manadream/triple-bypass-Version-2/bom/3bpv2-m bom alternate.xlsx

ID | Designator | Footprint | Quantity | Value | Manufacturer Part | Manufacturer | Description
1 | C1, C2, C20, C3, C4, C5, C6 | 0603' | 7 | 0.1uF/50V | 06035C104M4T2A | AVX
2 | C10, C11, C12, C13, C14, C15 | 0603' | 6 | 1uF/16V | C0603C105K4PACTU | KEMET
3 | C16, C9 | 0805’ | 2 | 10uF/16V | EMK212BJ106KG-T | Taiyo Yuden
4 | C17 | 1206’ | 1 | 10uF/25V | TMK316AB7106KLHT | Taiyo Yuden
5 | C18, C19 | 0603' | 2 | 150pF/50V | 0603N151J500CT | Walsin
6 | C21, C22, C23 | CP_EIA-3528-15_AVX-H | 3 | 47uF/10V | TAJB476M010TNJ | AVX
7 | C7 | 1206’ | 1 | 22uF/25V | CL31A226KAHNNNE | Samsung
8 | C8 | CP_EIA-3528-15_AVX-H | 1 | 220uF/6.3V | T55B227M6R3C0025 | Vishay
9 | R1, R15 | 0603' | 2 | 2.20k | CRCW06032K20FKEB | Vishay
10 | R10, R43 | 0603' | 2 | 4.7k | RK73H1JTTD4701F | KOA Speer
11 | R11, R14, R17 | 0603' | 3 | 75 | RK73H1JTTDD75R0F | KOA Speer
12 | R16 | 0603' | 1 | 750 | CR0603-FX-7500ELF | Bourns
13 | R2, R3, R4, R5 | 0603' | 4 | 5.62k | AC0603FR-075K62L | YAGEO
14 | R20, R21, R22, R23, R24, R25 | 0603' | 6 | 210k | AC0603FR-07210KL | YAGEO
15 | R26, R27, R30, R33, R41, R42 | 0603' | 6 | 10k | RK73H1JTTD1002F | KOA Speer
16 | R28, R31 | 0603' | 2 | 130k | CR0603-FX-1303ELF | Bourns
17 | R29, R32 | 0603' | 2 | 100k | RK73H1JTTD1003F | KOA Speer
18 | R34, R35 | 0603' | 2 | 300k | RK73H1JTTD3003F | KOA Speer
19 | R36, R37, R44 | 0603' | 3 | 330 | RK73H1JTTD3300F | KOA Speer
20 | R38, R39, R40 | 0603' | 3 | 511 | RK73H1JTTD5110F | KOA Speer
21 | R6, R7, R8, R9 | 0603' | 4 | 1k | RK73H1JTTD1001F | KOA Speer
22 | U1 | SOIC-14 | 1 | TL974IDR | TL974IDR | Texas Instruments
23 | U2 | TSSOP-14 | 1 | THS7374IPWR | THS7374IPWR | Texas Instruments
