manadream/triple-bypass-Version-2/bom/3bpv2-m bom pcb power.xlsx

ID | Designator | Footprint | Quantity | Value | Manufacturer Part | Manufacturer | Description
1 | C1, C2, C20, C3, C4, C5, C6 | 0603' | 7 | 0.1uF/50V | C0603C104M5RACTU | KEMET
2 | C10, C11, C12, C13, C14, C15 | 0603' | 6 | 1uF/16V | C0603C105K4PACTU | KEMET
3 | C16, C9 | 0805’ | 2 | 10uF/16V | EMK212BJ106KG-T | Taiyo Yuden
4 | C17 | 1206’ | 1 | 10uF/25V | CL31B106KAHNNNE | Samsung
5 | C18, C19 | 0603' | 2 | 150pF/25V | CC0603KRX7R8BB151 | YAGEO
6 | C21, C22, C23 | CP_EIA-3528-15_AVX-H | 3 | 47uF/10V | TAJB476M010TNJ | AVX
7 | C7 | 1206’ | 1 | 22uF/25V | CL31A226KAHNNNE | Samsung
8 | C8 | CP_EIA-3528-15_AVX-H | 1 | 220uF/6.3V | F930J227MBA | AVX
9 | R1, R15 | 0603' | 2 | 2.20k | GPR06032K2 | PCB Power
10 | R10, R43 | 0603' | 2 | 4.7k | GPR06034K7 | PCB Power
11 | R11, R14, R17 | 0603' | 3 | 75 | ERJ-3GEYJ750V | Panasonic
12 | R16 | 0603' | 1 | 750 | CR0603-FX-7500ELF | Bourns
13 | R2, R3, R4, R5 | 0603' | 4 | 5.62k | RK73H1JTTD5621F | KOA Speer
14 | R20, R21, R22, R23, R24, R25 | 0603' | 6 | 210k | CRCW0603210KFKEA | Vishay
15 | R26, R27, R30, R33, R41, R42 | 0603' | 6 | 10k | GPR060310K | PCB Power
16 | R28, R31 | 0603' | 2 | 130k | ERJ-3EKF1303V | Panasonic
17 | R29, R32 | 0603' | 2 | 100k | GPR0603100K | PCB Power
18 | R34, R35 | 0603' | 2 | 300k | RK73H1JTTD3003F | KOA Speer
19 | R36, R37, R44 | 0603' | 3 | 330 | RK73H1JTTD3300F | KOA Speer
20 | R38, R39, R40 | 0603' | 3 | 510 | GPR06034510R | PCB Power
21 | R6, R7, R8, R9 | 0603' | 4 | 1k | GPR06031K | PCB Power
22 | U1 | SOIC-14 | 1 | TL974IDR | TL974IDR | Texas Instruments
23 | U2 | TSSOP-14 | 1 | THS7374IPWR | THS7374IPWR | Texas Instruments
