manadream/triple-bypass-Version-2/Schematic_3bp v2_2022-05-17.pdf

+5V

+5V

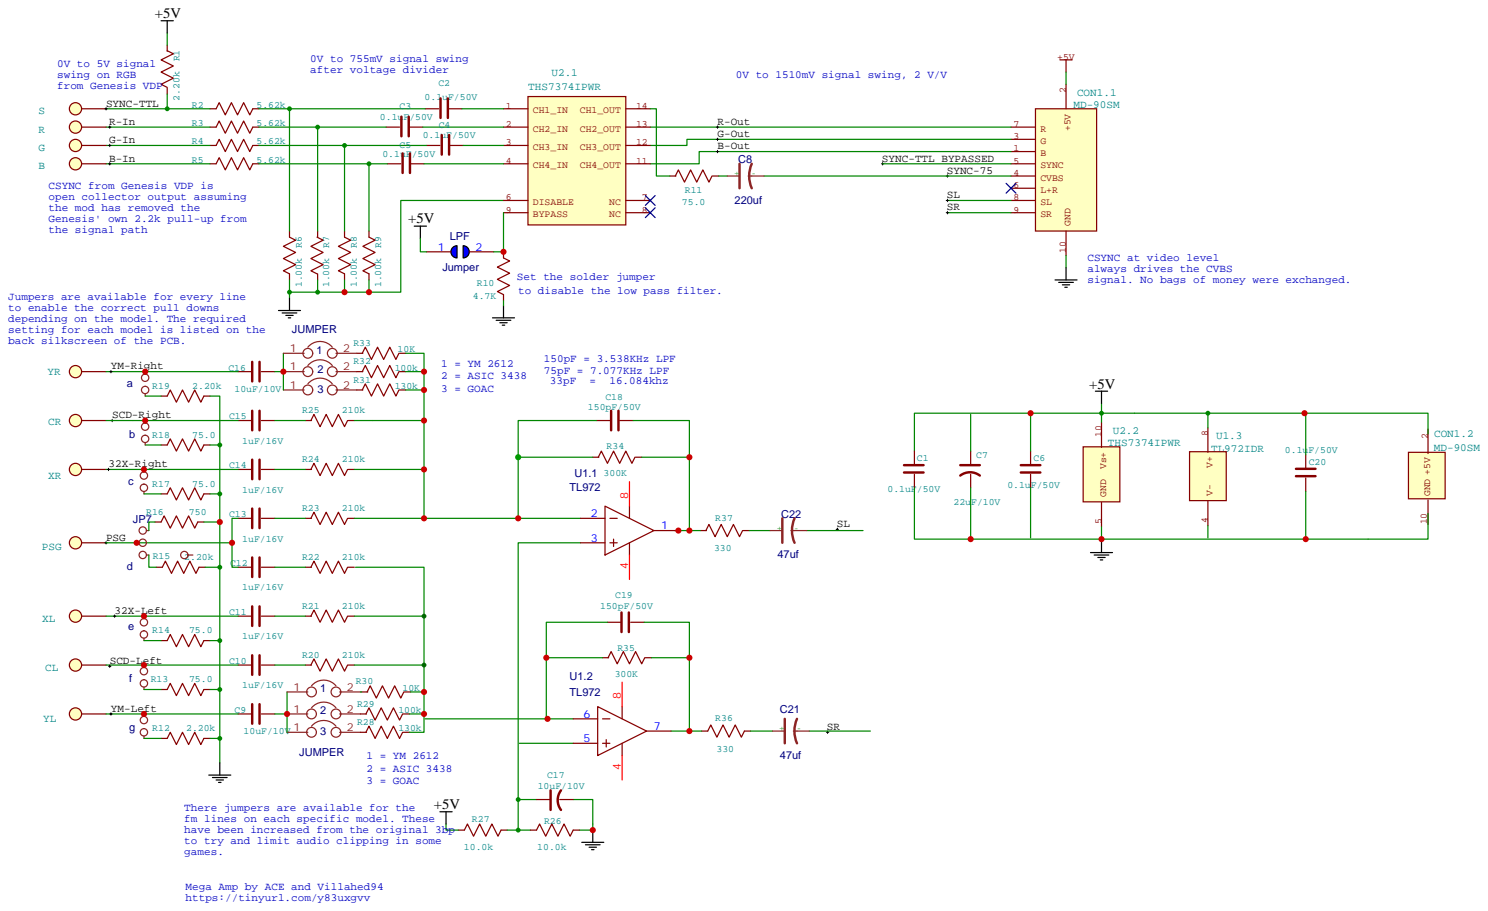
[picture p1: page 1]

CSYNC from Genesis VDP is
open collector output assuming
the mod has removed the
Genesis' own 2.2k pull-up from
the signal path

CSYNC at video level
always drives the CVBS
signal. No bags of money were exchanged.

Set the solder jumper
to disable the low pass filter.

Jumpers are available for every line
to enable the correct pull downs
depending on the model. The required
setting for each model is listed on the
back silkscreen of the PCB.

There jumpers are available for the
fm lines on each specific model. These
have been increased from the original 3bp
to try and limit audio clipping in some
games.

Mega Amp by ACE and Villahed94
https://tinyurl.com/y83uxgvv
