manadream/triple-bypass-Version-2/kicad/3bp v2M.kicad_pcb

## KiCad design kicad/3bp v2M.kicad_pcb (2025-06-27)

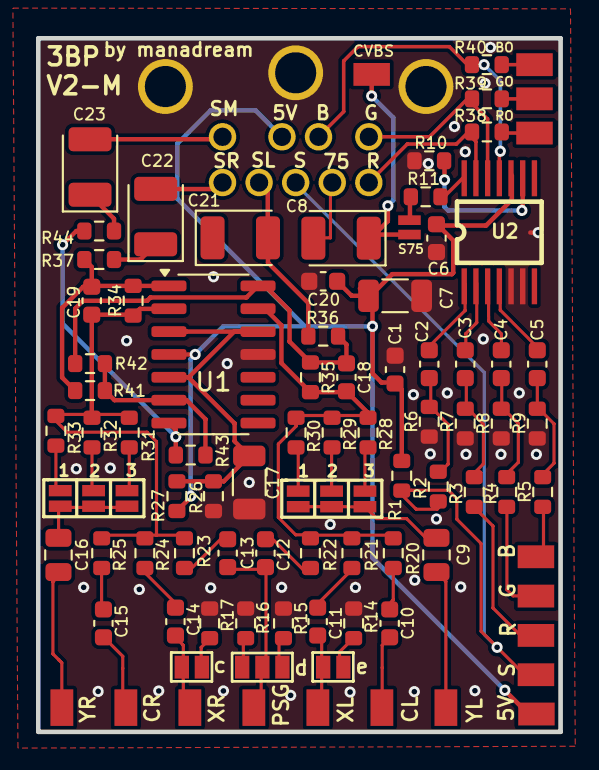
[picture p2: board 3bp v2M.kicad_pcb from above]

Board: 2 copper layers, 29.0 x 38.5 mm, 84 parts (0 on the bottom side), 28 nets.

Parts:
1, 1#2: 3; JUMPER
5V1: TP_50; TP50
B1: TP_50; TP50
C1, C2, C3, C4, C5, C6, C20: 0.1uF/50V; C_0603_1608Metric
C7: 22uF/10V; C_1206_3216Metric
C8: 220uF/6.3V; CP_EIA-3528-15_AVX-H
C9, C16: 10uF/16V; C_0805_2012Metric
C10, C11, C12, C13, C14, C15: 1uF/16V; C_0603_1608Metric
C17: 10uF/16V; C_1206_3216Metric
C18, C19: 150pF/50V; C_0603_1608Metric
C21, C22, C23: 47uF/10V; CP_EIA-3528-15_AVX-H
CON1: MD-90SM
G: LOGO; OSHW-LOGO_5MM
G1: TP_50; TP50
R1, R15: 2.20k; R_0603_1608Metric
R2, R3, R4, R5: 5.62k; R_0603_1608Metric
R6, R7, R8, R9: 1k; R_0603_1608Metric
R10, R43: 4.7k; R_0603_1608Metric
R11, R14, R17: 75.0; R_0603_1608Metric
R16: 750; R_0603_1608Metric
R20, R21, R22, R23, R24, R25: 210k; R_0603_1608Metric
R26, R27, R30, R33, R41, R42: 10k; R_0603_1608Metric
R28, R31: 130k; R_0603_1608Metric
R29, R32: 100k; R_0603_1608Metric
R34, R35: 300k; R_0603_1608Metric
R36, R37, R44: 330; R_0603_1608Metric
R38, R39, R40: 511; R_0603_1608Metric
RIN: TP_50; TP50
S1: TP_50; TP50
SL1: TP_50; TP50
SN1: TP_50; TP50
SR2: TP_50; TP50
U1: TL974IDR; SOIC-14_3.9x8.7mm_P1.27mm
U2: THS7374IPWR; TSSOP-14
XL1: TP_50; TP50
XR2: TP_50; TP50
YL1: TP_50; TP50
YR2: TP_50; TP50
c: JUMPER_PADSX2
d: JUMPER_PADSX3
e: JUMPER_PADSX2

Connections:
32X-LEFT: C11.1, C11.2, R14.1, R21.1, SL1.1, e.1, e.2
32X-RIGHT: C14.1, C14.2, R17.1, R24.1, XR2.1, c.1, c.2
+5V: 5V1.1, C1.1, C6.1, C7.1, C20.1, CON1.2, R1.2, R27.1, U1.4, U2.10
B-IN: B1.1, C5.1, C5.2, R5.1, R5.2, R9.2, U2.4
B-OUT: CON1.1, R40.1, R40.2, U2.11
G-IN: C4.1, C4.2, G1.1, R4.1, R4.2, R8.2, U2.3
G-OUT: CON1.3, R39.1, R39.2, U2.12
GND: C1.2, C6.2, C7.2, C17.2, C20.2, CON1.10, R6.1, R7.1, R8.1, R9.1, R10.1, R14.2, R15.2, R16.2, R17.2, R26.1, U1.11, U2.5, U2.6
LEFT: C18.2, R20.2, R21.2, R22.2, R28.2, R29.2, R30.2, R35.2, U1.13
LOUT: C18.1, R35.1, R36.2, R42.2, U1.14
LPF: R10.2, U2.9
MONO: R41.1, R42.1, R43.1, U1.6
MOUT: R43.2, R44.1, U1.7
OPAVREF: C17.1, R26.2, R27.2, U1.3, U1.5, U1.12
PSG: C12.1, C12.2, C13.1, C13.2, R15.1, R16.1, R22.1, R23.1, SN1.1, d.1, d.2, d.3
R-IN: C3.1, C3.2, R3.1, R3.2, R7.2, RIN.1, U2.2
R-OUT: CON1.7, R38.1, R38.2, U2.13
RIGHT: C19.1, R23.2, R24.2, R25.2, R31.2, R32.2, R33.2, R34.1, U1.2
ROUT: C19.2, R34.2, R37.1, R41.2, U1.1
SCD-LEFT: C10.1, C10.2, R20.1, XL1.1
SCD-RIGHT: C15.1, C15.2, R25.1, SR2.1
SL: C21.1, C21.2, CON1.8, R36.1
SM: C23.1, C23.2, CON1.6, R44.2
SR: C22.1, C22.2, CON1.9, R37.2
SYNC-75: C8.1, C8.2, CON1.4, R11.1
SYNC-OUT: C2.1, C2.2, CON1.5, R1.1, R2.1, R2.2, R6.2, R11.2, S1.1, U2.1, U2.14
YM-LEFT: 1.1, 1.2, C9.1, C9.2, R28.1, R29.1, R30.1, YL1.1
YM-RIGHT: 1#2.1, 1#2.2, C16.1, C16.2, R31.1, R32.1, R33.1, YR2.1
