manadream/triple-bypass-Version-2/(commit log)

2025-05-29 added my modifications
    [3bp v2.1-B_Cu.gbl, 3bp v2.1-B_Mask.gbs, 3bp v2.1-B_Paste.gbp, 3bp v2.1-B_Silkscreen.gbo, 3bp v2.1-Edge_Cuts.gm1, 3bp v2.1-F_Cu.gtl, 3bp v2.1-F_Mask.gts, 3bp v2.1-F_Paste.gtp]
2025-06-27 Added 4 channel op amp to restore mono and cleaned up repo
    [3bp v2.1-B_Cu.gbl, 3bp v2.1-B_Mask.gbs, 3bp v2.1-B_Paste.gbp, 3bp v2.1-B_Silkscreen.gbo, 3bp v2.1-Edge_Cuts.gm1, 3bp v2.1-F_Cu.gtl, 3bp v2.1-F_Mask.gts, 3bp v2.1-F_Paste.gtp]
