manadream/triple-bypass-Version-2/(notices)

Notices in the files:
kicad/3bp v2M.kicad_pcb:
Licensed under CERN OHL v.1.2
